patmtp35/Alim-Convert-12_24V-5v/stl/boitier_alim_5v_din_v3.stl

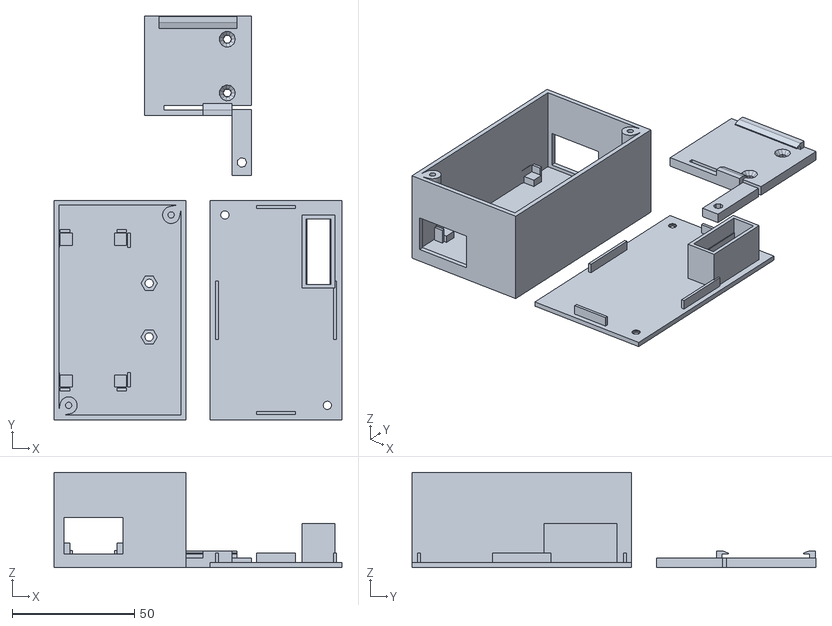
[picture p2: CAD file, 2026-10-25]
stl/boitier_alim_5v_din_v3.stl
118.0 x 165.5 x 39.0
