patmtp35/Alim-Convert-12_24V-5v/(commit log)

2026-10-25 Boîtier DIN 3 modules pour alim 24V→5V + porte-fusible, README
    Claude-Session: https://claude.ai/code/session_01RcDBuGFtguSLRcijQv7jMH
    [boitier_alim_5v_din.scad]
2026-10-25 Ajout de la vue plaque (3 pièces à plat) dans le SCAD
    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
    [boitier_alim_5v_din.scad]
2026-10-25 Ajout photo du matériel, schéma de connexion et section fusibles compatibles
    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
2026-10-25 Entrée 9-36 V annoncée par le vendeur, diode externe rendue optionnelle
    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
2026-10-25 Refonte du schéma de connexion (D1 interne, D2 optionnelle, connecteurs)
    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
2026-10-25 Suppression de la diode externe du schéma et du README
    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
2026-10-25 Clip rail : ajout des trous de fixation alignés sur la base, vis M3x5
    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
    [boitier_alim_5v_din.scad]
2026-10-25 Clip rail : reprise du clip validé du boîtier Esp32/eSmart3 (fond 4 mm, écrous M3)
    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
    [boitier_alim_5v_din.scad]
2026-10-25 Ajout du STL (vue plaque v3)
    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
    [boitier_alim_5v_din_v3.stl]
